ThunderFly-aerospace/MINI4/README.md

# TFESC
VESC-based ESC designed for unmanned drones
