ThunderFly-aerospace/MINI4/doc/gen/img/pcb/TFESC01-bottom.png

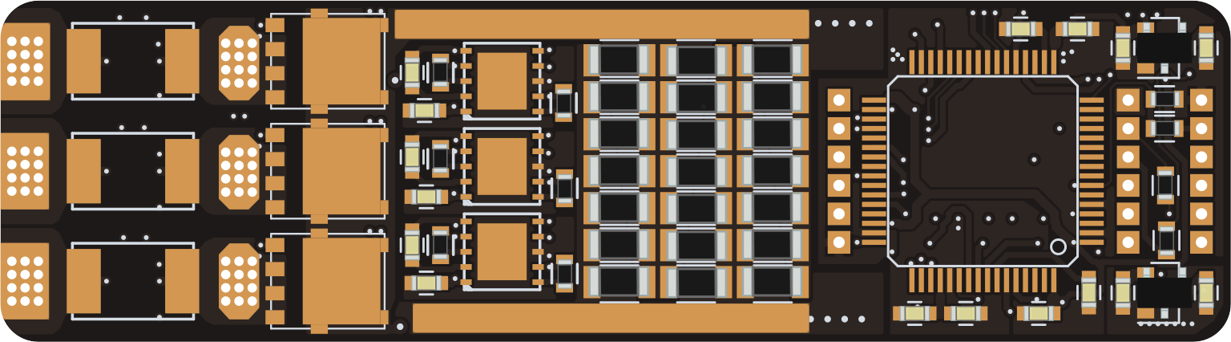
doc/gen/img/pcb/TFESC01-bottom.png
