ThunderFly-aerospace/MINI4/doc/gen/img/pcb/TFESC01-top.png

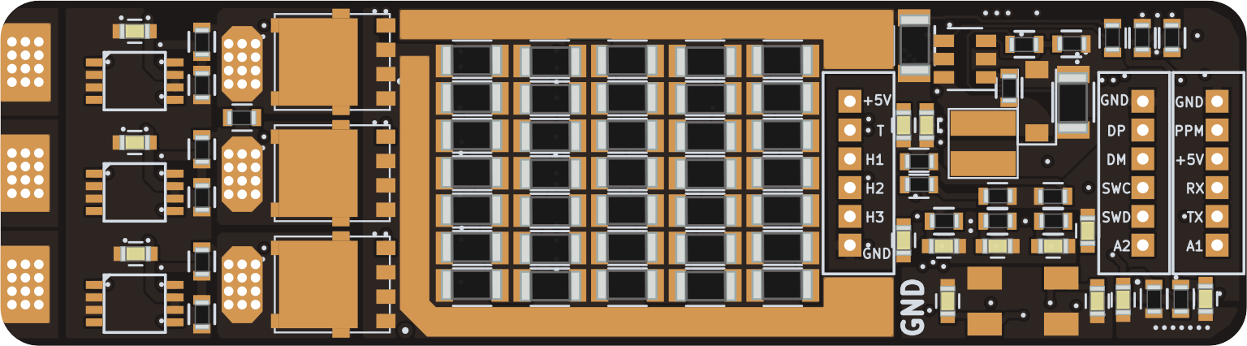
doc/gen/img/pcb/TFESC01-top.png
