ThunderFly-aerospace/MINI4/doc/gen/dxf/TFESC01-Edge_Cuts.dxf

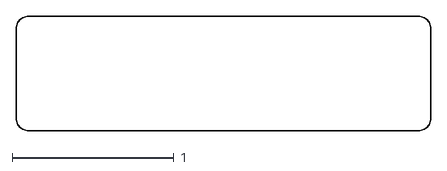
[picture p3: CAD file, 2022-12-15]
doc/gen/dxf/TFESC01-Edge_Cuts.dxf
2.56 x 0.709
