ThunderFly-aerospace/MINI4/doc/gen/TFESC01.step

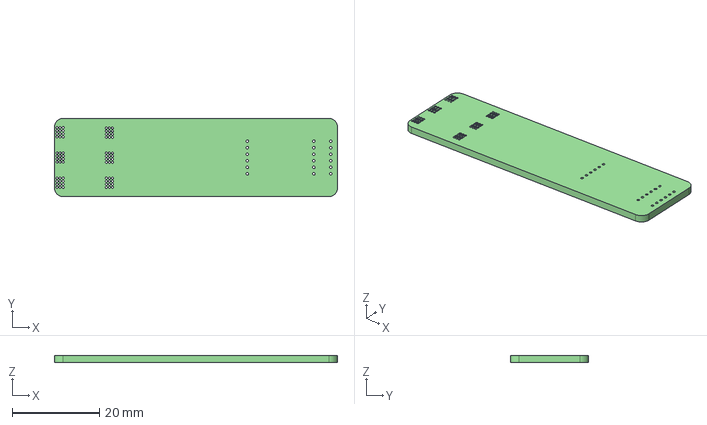
[picture p4: CAD file, 2022-12-15]
doc/gen/TFESC01.step
65.0 x 18.0 x 1.60 mm
