ThunderFly-aerospace/MINI4/doc/gen/dxf/TFESC01-B_Cu.dxf

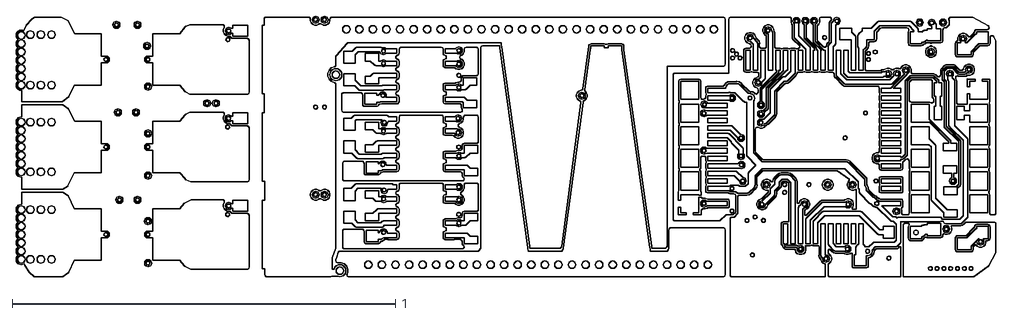
[picture p5: CAD file, 2022-12-15]
doc/gen/dxf/TFESC01-B_Cu.dxf
2.56 x 0.68
