ThunderFly-aerospace/MINI4/doc/gen/dxf/TFESC01-User_Drawings.dxf

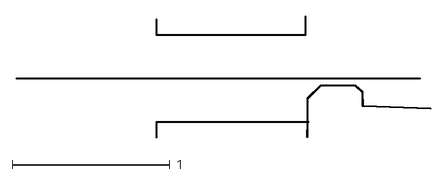
[picture p6: CAD file, 2022-12-15]
doc/gen/dxf/TFESC01-User_Drawings.dxf
2.63 x 0.772
