ThunderFly-aerospace/MINI4/hw/sch_pcb/3dmodels/3921_RESISTOR.STEP

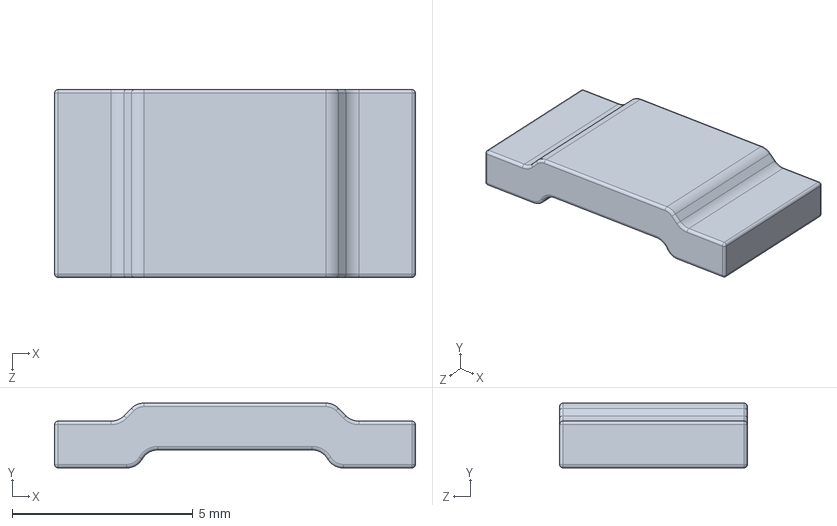
[picture p7: CAD file, 2022-12-15]
hw/sch_pcb/3dmodels/3921_RESISTOR.STEP
10.0 x 1.80 x 5.20 mm
