ThunderFly-aerospace/MINI4/doc/gen/dxf/TFESC01-F_Courtyard.dxf

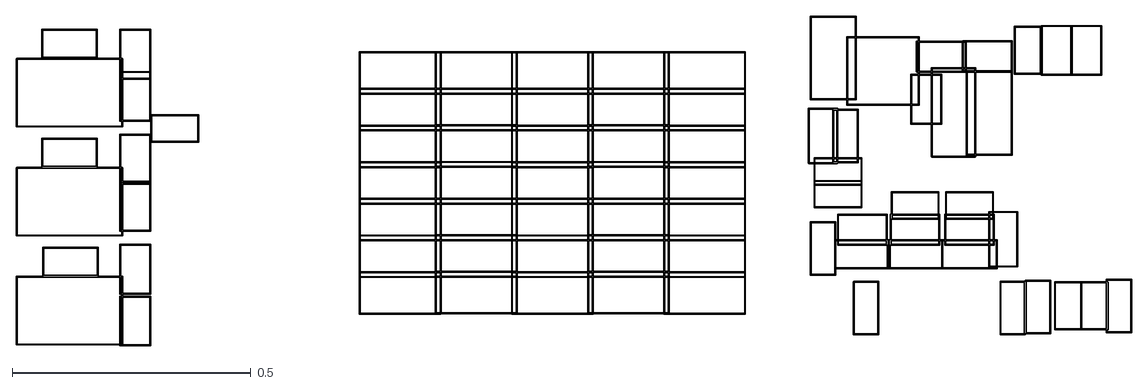
[picture p8: CAD file, 2022-12-15]
doc/gen/dxf/TFESC01-F_Courtyard.dxf
2.34 x 0.691
