ThunderFly-aerospace/MINI4/doc/gen/dxf/TFESC01-B_Courtyard.dxf

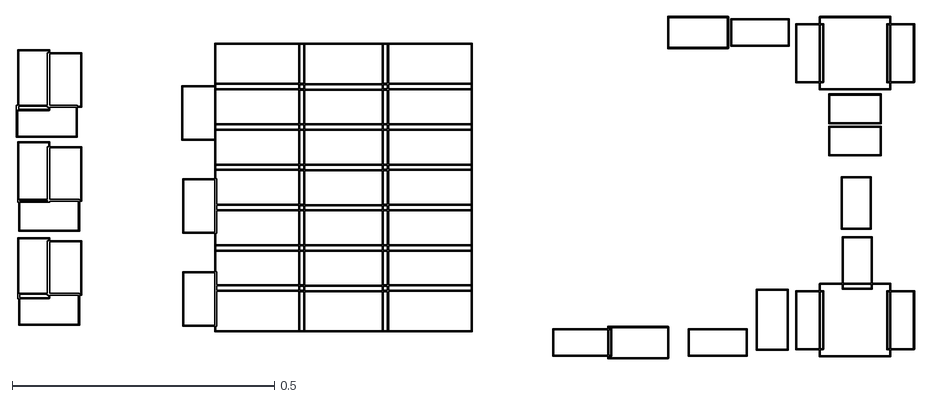
[picture p9: CAD file, 2022-12-15]
doc/gen/dxf/TFESC01-B_Courtyard.dxf
1.71 x 0.652
