ThunderFly-aerospace/MINI4/doc/gen/dxf/TFESC01-B_Fab.dxf

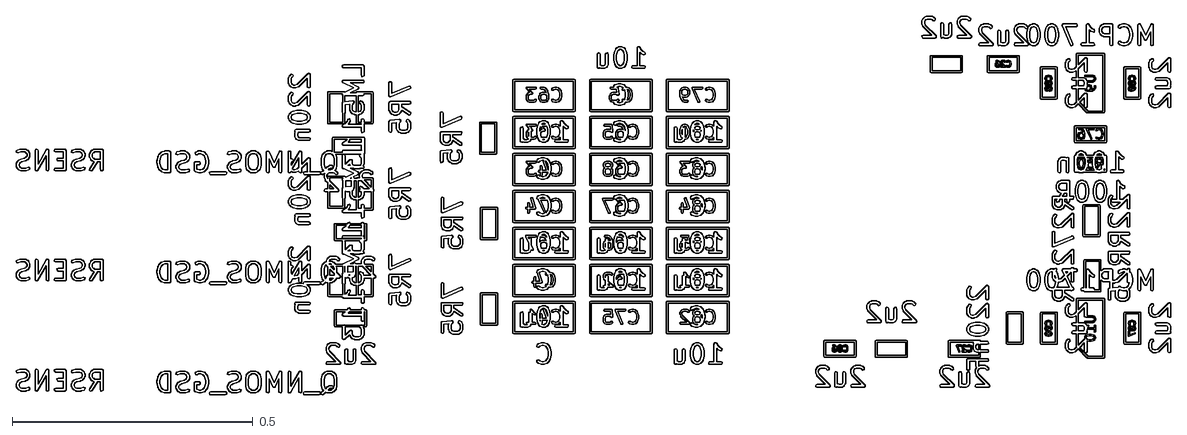
[picture p10: CAD file, 2022-12-15]
doc/gen/dxf/TFESC01-B_Fab.dxf
2.40 x 0.785
