ThunderFly-aerospace/MINI4/doc/gen/dxf/TFESC01-In2_Cu.dxf

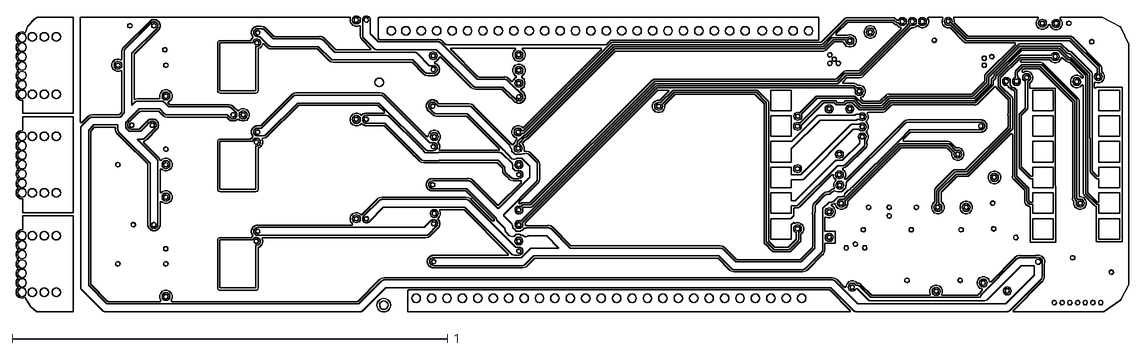
[picture p12: CAD file, 2022-12-15]
doc/gen/dxf/TFESC01-In2_Cu.dxf
2.56 x 0.68
