ThunderFly-aerospace/MINI4/doc/gen/dxf/TFESC01-F_Fab.dxf

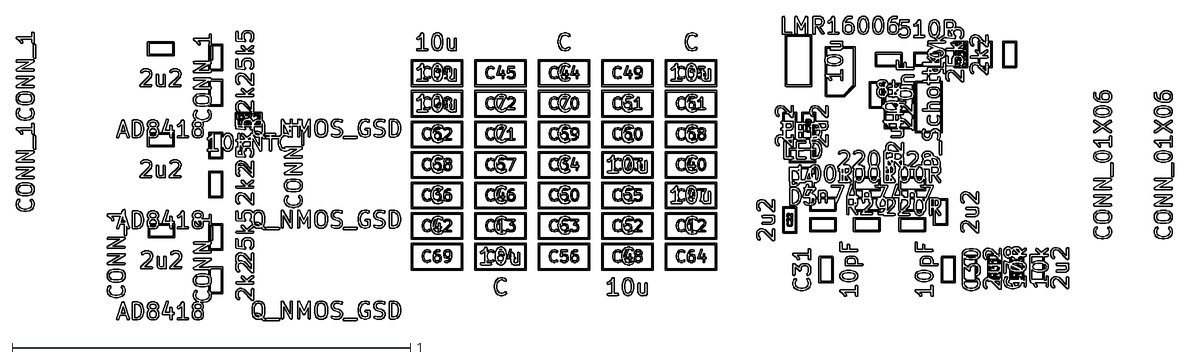
[picture p13: CAD file, 2022-12-15]
doc/gen/dxf/TFESC01-F_Fab.dxf
2.91 x 0.764
