ThunderFly-aerospace/MINI4/doc/gen/dxf/TFESC01-In1_Cu.dxf

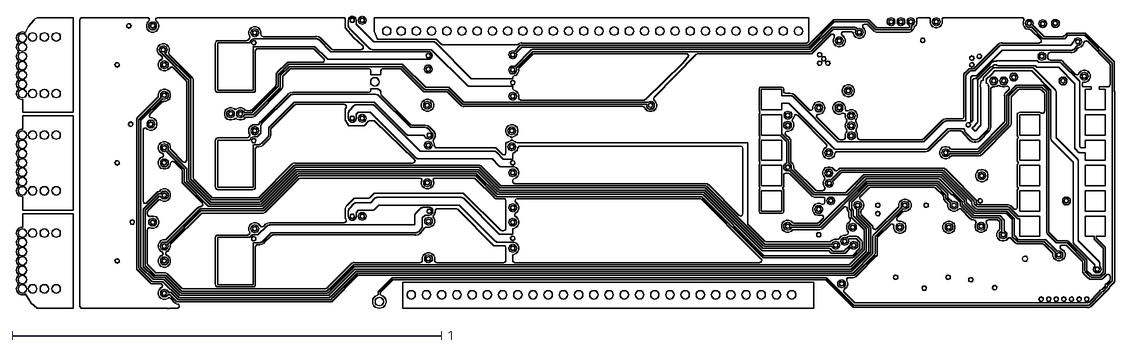
[picture p14: CAD file, 2022-12-15]
doc/gen/dxf/TFESC01-In1_Cu.dxf
2.56 x 0.68
