ThunderFly-aerospace/MINI4/(list of files, cad)

Other CAD files:
hw/sch_pcb/3dmodels/pqfn 5x6.wrl.sldprt
hw/sch_pcb/3dmodels/user library-pqfn 5x6.wrl.sldprt
doc/gen/dxf/TFESC01-User_Eco2.dxf
doc/gen/dxf/TFESC01-B_Adhesive.dxf
doc/gen/dxf/TFESC01-Margin.dxf
doc/gen/dxf/TFESC01-User_Eco1.dxf
doc/gen/dxf/TFESC01-User_Comments.dxf
doc/gen/dxf/TFESC01-F_Adhesive.dxf
doc/gen/dxf/TFESC01-B_Mask.dxf
doc/gen/dxf/TFESC01-B_Paste.dxf
doc/gen/dxf/TFESC01-B_Silkscreen.dxf
doc/gen/dxf/TFESC01-F_Mask.dxf
doc/gen/dxf/TFESC01-F_Paste.dxf
doc/gen/dxf/TFESC01-F_Silkscreen.dxf
