ThunderFly-aerospace/MINI4/doc/gen/TFESC01-schematic.pdf

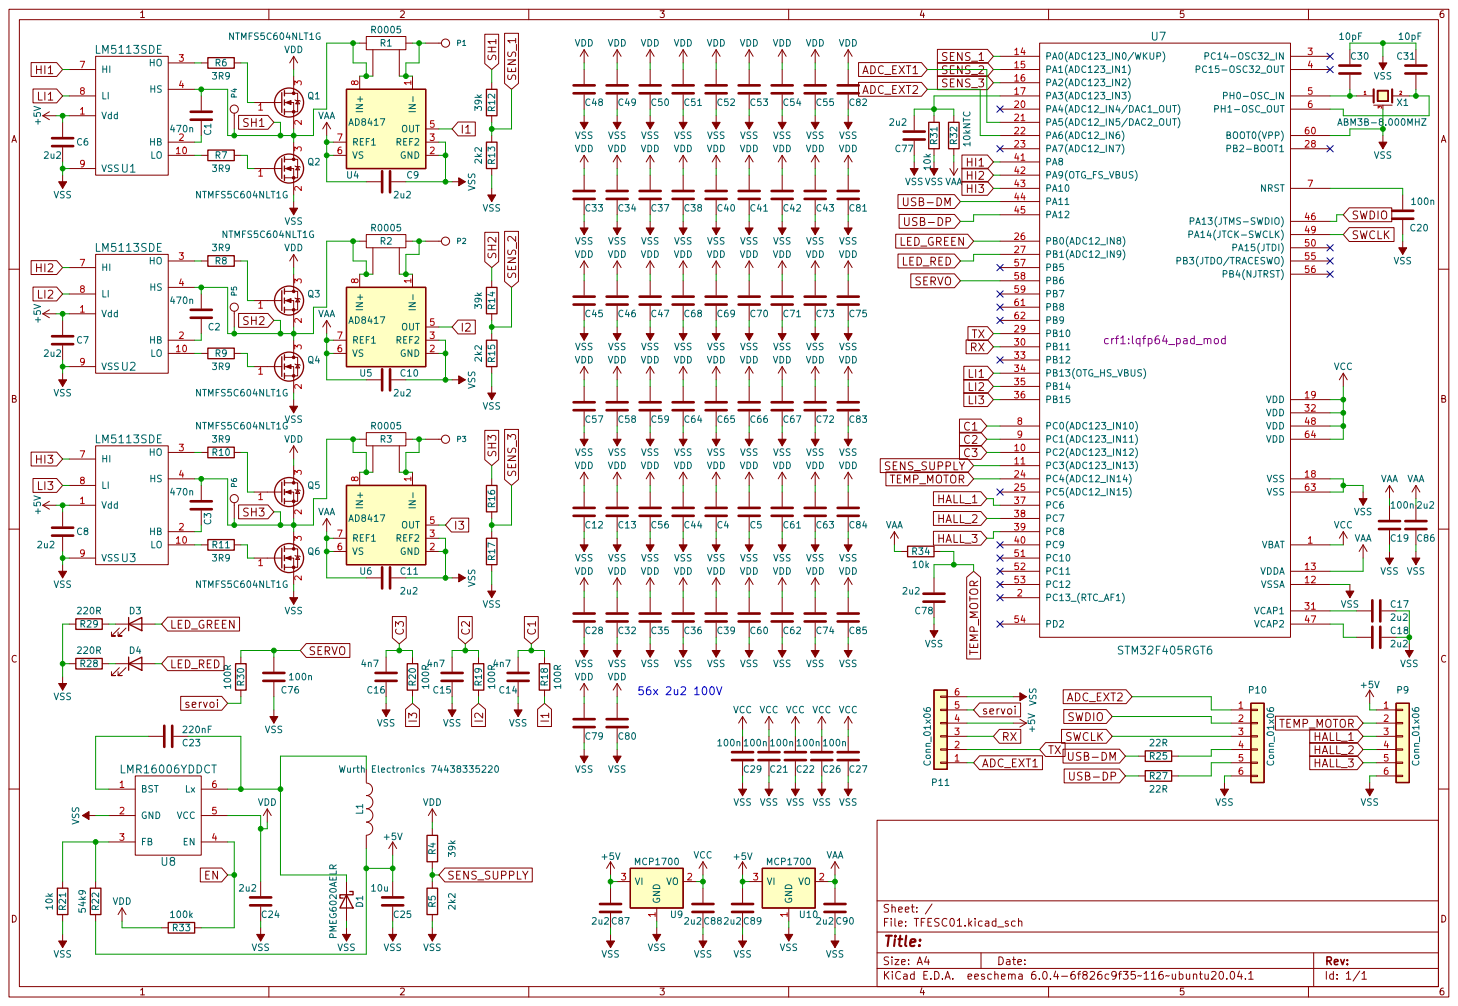
[picture p15: page 1]

2 3 Q5 NTMFS5C604NLT1G IN- 1 GND 2 REF2 3 OUT 5 VS 6 REF1 7 IN+

100n VCC VCC VCC VCC VCC
