ThunderFly-aerospace/MINI4/hw/sch_pcb/TFESC01.kicad_pcb

## KiCad design hw/sch_pcb/TFESC01.kicad_pcb (2022-12-15)

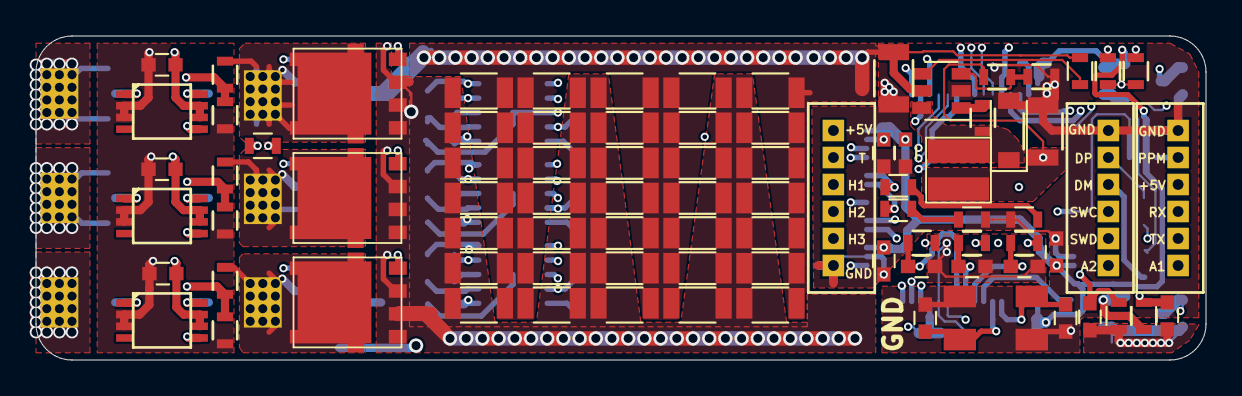
[picture p16: board TFESC01.kicad_pcb from above]

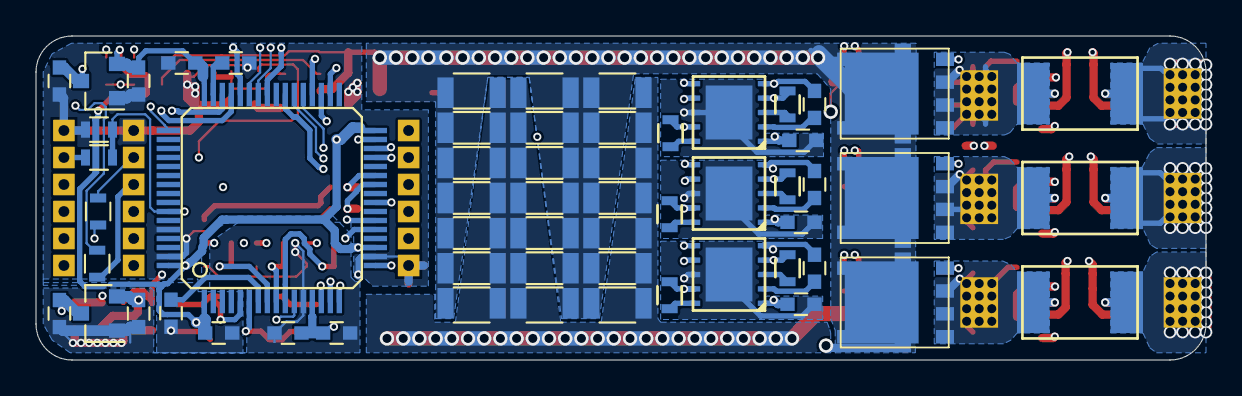
[picture p17: board TFESC01.kicad_pcb from below]

Board: 4 copper layers, 65.0 x 18.0 mm, 151 parts (59 on the bottom side), 72 nets.

Parts:
C1, C2, C3: 220n; C_0603
C4, C5, C12, C13, C24, C25, C28, C32, C39, C48, C60, C61, C62, C63, C74, C75, C79, C82, C84, C85: 10u; R_1206
C6, C7, C8, C9, C10, C11, C17, C18, C19, C21, C22, C26, C27, C29, C77, C78, C86, C87, C88, C89, C90: 2u2; C_0603
C14, C15, C16: 4n7; C_0603
C20: 220nF; C_0603
C23: 220nF; R_0603
C30, C31: 10pF; C_0603
C33, C34, C35, C36, C37, C38, C40, C41, C42, C43, C44, C45, C46, C47, C49, C50, C51, C52, C53, C54, C55, C56, C57, C58, C59, C64, C65, C66, C67, C68, C69, C70, C71, C72, C73, C80, C81, C83: C; R_1206
C76: 100n; R_0603
D1: D_Schottky; D_SOD-123
D3, D4: LED; R_0603
L1: 22uH; WE-MAPI
P1, P2, P3, P4, P5, P6: CONN_1; prekov
P9, P10, P11: CONN_01X06; JST_ZH_1.5_6-Pin
Q1, Q2, Q3, Q4, Q5, Q6: Q_NMOS_GSD; DFN5
R1, R2, R3: RSENS; 2512Rv2
R4, R12, R14, R16: 25k5; R_0603
R5, R13, R15, R17: 2k2; R_0603
R6, R7, R8, R9, R10, R11: 7R5; R_0603
R18, R19, R20, R30: 100R; R_0603
R21: 510R; R_0603
R22: 8k; R_0603
R25, R27: 22R; R_0603
R28, R29: 220R; R_0603
R31, R33, R34: 10k; R_0603
R32: 10kNTC; R_0603
U1, U2, U3: LM5113; WSON10_
U4, U5, U6: AD8418; MSOP
U7: STM32F40X_LQFP64; lqfp64_pad_mod
U8: LMR16006; SOT-23-6
U9, U10: MCP1700; SOT-23
X1: CRYSTAL_SMD; 5x3.2KRISTALL

Connections:
+5V: C6.1, C7.1, C8.1, C25.2, C87.1, C89.1, L1.2, P9.1, P11.4, R22.1, U1.1, U2.1, U3.1, U9.3, U10.3
ADC_EXT1: P11.1, U7.21
ADC_EXT2: P10.1, U7.22
C1: C14.2, R18.2, U7.8
C2: C15.2, R19.2, U7.9
C3: C16.2, R20.2, U7.10
EN: R33.2, U8.4
HALL_1: P9.3, U7.37
HALL_2: P9.4, U7.38
HALL_3: P9.5, U7.39
HI1: U1.6, U7.41
HI2: U2.6, U7.42
HI3: U3.6, U7.43
I1: R18.1, U4.5
I2: R19.1, U5.5
I3: R20.1, U6.5
LED_GREEN: D3.2, U7.26
LED_RED: D4.2, U7.27
LI1: U1.7, U7.34
LI2: U2.7, U7.35
LI3: U3.7, U7.36
unnamed: C1.1, U1.2
unnamed: C2.1, U2.2
unnamed: C3.1, U3.2
unnamed: C17.2, U7.31
unnamed: C18.2, U7.47
unnamed: C20.2, U7.7
unnamed: C23.1, D1.1, L1.1, U8.6
unnamed: C23.2, U8.1
unnamed: C30.1, U7.5, X1.1
unnamed: C31.1, U7.6, X1.2
unnamed: C77.2, R31.2, R32.2, U7.17
unnamed: D3.1, R29.2
unnamed: D4.1, R28.2
unnamed: P1.1, R1.1, U4.1
unnamed: P2.1, R2.1, U5.1
unnamed: P3.1, R3.1, U6.1
unnamed: P10.4, R25.1
unnamed: P10.5, R27.1
unnamed: Q1.1, R6.1, U1.4
unnamed: Q2.1, R7.2, U1.9
unnamed: Q3.1, R8.1, U2.4
unnamed: Q4.1, R9.2, U2.9
unnamed: Q5.1, R10.1, U3.4
unnamed: Q6.1, R11.2, U3.9
unnamed: R6.2, U1.3
unnamed: R7.1, U1.10
unnamed: R8.2, U2.3
unnamed: R9.1, U2.10
unnamed: R10.2, U3.3
unnamed: R11.1, U3.10
unnamed: R21.2, R22.2, U8.3
RX: P11.3, U7.30
SENS_1: R12.1, R13.2, U7.14
SENS_2: R14.1, R15.2, U7.15
SENS_3: R16.1, R17.2, U7.16
SENS_SUPPLY: R4.2, R5.2, U7.11
SERVO: C76.2, R30.2, U7.58
SH1: C1.2, P4.1, Q1.2, Q2.3, R1.2, R12.2, U1.5, U4.8
SH2: C2.2, P5.1, Q3.2, Q4.3, R2.2, R14.2, U2.5, U5.8
SH3: C3.2, P6.1, Q5.2, Q6.3, R3.2, R16.2, U3.5, U6.8
SWCLK: P10.3, U7.49
SWDIO: P10.2, U7.46
TEMP_MOTOR: C78.2, P9.2, R34.2, U7.24
TX: P11.2, U7.29
USB-DM: R25.2, U7.44
USB-DP: R27.2, U7.45
VAA: C9.2, C10.2, C11.2, C19.1, C86.1, C90.1, R32.1, R34.1, U4.6, U4.7, U5.6, U5.7, U6.6, U6.7, U7.13, U10.2
VCC: C21.1, C22.1, C26.1, C27.1, C29.1, C88.1, U7.1, U7.19, U7.32, U7.48, U7.64, U9.2
VDD: C4.1, C5.1, C12.1, C13.1, C24.2, C28.1, C32.1, C33.1, C34.1, C35.1, C36.1, C37.1, C38.1, C39.1, C40.1, C41.1, C42.1, C43.1, C44.1, C45.1, C46.1, C47.1, C48.1, C49.1, C50.1, C51.1, C52.1, C53.1, C54.1, C55.1, C56.1, C57.1, C58.1, C59.1, C60.1, C61.1, C62.1, C63.1, C64.1, C65.1, C66.1, C67.1, C68.1, C69.1, C70.1, C71.1, C72.1, C73.1, C74.1, C75.1, C79.1, C80.1, C81.1, C82.1, C83.1, C84.1, C85.1, Q1.3, Q3.3, Q5.3, R4.1, R33.1, U8.5
VSS: C4.2, C5.2, C6.2, C7.2, C8.2, C9.1, C10.1, C11.1, C12.2, C13.2, C14.1, C15.1, C16.1, C17.1, C18.1, C19.2, C20.1, C21.2, C22.2, C24.1, C25.1, C26.2, C27.2, C28.2, C29.2, C30.2, C31.2, C32.2, C33.2, C34.2, C35.2, C36.2, C37.2, C38.2, C39.2, C40.2, C41.2, C42.2, C43.2, C44.2, C45.2, C46.2, C47.2, C48.2, C49.2, C50.2, C51.2, C52.2, C53.2, C54.2, C55.2, C56.2, C57.2, C58.2, C59.2, C60.2, C61.2, C62.2, C63.2, C64.2, C65.2, C66.2, C67.2, C68.2, C69.2, C70.2, C71.2, C72.2, C73.2, C74.2, C75.2, C76.1, C77.1, C78.1, C79.2, C80.2, C81.2, C82.2, C83.2, C84.2, C85.2, C86.2, C87.2, C88.2, C89.2, C90.2, D1.2, P9.6, P10.6, P11.6, Q2.2, Q4.2, Q6.2, R5.1, R13.1, R15.1, R17.1, R21.1, R28.1, R29.1, R31.1, U1.8, U2.8, U3.8, U4.2, U4.3, U5.2, U5.3, U6.2, U6.3, U7.12, U7.18, U7.60, U7.63, U8.2, U9.1, U10.1, X1.3
servoi: P11.5, R30.1
