ThunderFly-aerospace/MINI4/(threads)

Thread 3 (2021-08-02):

Konektory

kaklik, 2021-08-02:
Konektory zvolit tak, aby bylo možné regulátor přímo propojovat s autopilotem. Aktuální situace je taková:

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

kaklik, 2022-12-17:
Konektory, které je potřeba doplnit:

- [ ] CAN konektor  - asi pouze jeden s tím že ESC bude vždy na konci sběrnice
- [ ] Dronecode debug port - Kotleta20 jej má společný s RCPWM vstupem.
- [ ] Napájecí konektor XT60
- [ ] 3F XT60 konektor pro připojení motoru

kaklik, 2023-01-08:
Vypadá to, že AMASS nevyrábí 3pin verzi konektoru XT60 do PCB, ale tenhle 3pin konektor je dostupný pouze ve variantě MR30, která má jmenovitý zatěžovací proud pouze 15A.

roman-dvorak, 2023-05-14:
Napájecí konektor by měl být takový (i všechny ostatní), aby co nejvíce zachovával kompatibilitu. (Pokud není zaměnitelný jiným osazením). Tj, aby do toho šlo zapojit koupitelné akumulátory či dostupné powermoduly.

kaklik, 2024-04-16:
Nově se teď objevilo [tohle ESC](https://www.hargravetechnologies.com/products/microdrive-lpi), jeho konstrukce je zajímavá zejména tím, že výkonové konektory nahradily letovacími maticemi pro šrouby podobně, jako to máme  vyřešené v QFH anténách.

Thread 2 (2022-12-09):

Výchozí design

kaklik, 2022-12-09:
Prohledával jsem výchozí KiCAD projekty ze kterých by bylo možné vyjít.  Hledal jsem zejména tyto parametry:

- Použití aktuálních součástek
- Využití KiCAD návrhu
- Udržovaný projekt.

Konkrétní projekt, který by tato kritéria perfektně splňoval jsem nenašel. Hlavní potíž je ta, že všechny projekty založené na VESC mají poslední commity několik roků zpátky. Nedovedu to vysvětlit, protože pro UAV vhodný design podle mě stále chybí.

Našel jsem ale:

- [VESC MINI4](https://github.com/norn93/AgriESC) - tohle [prodává holybro](http://www.holybro.com/product/holybro-mini-foc-esc-based-on-vesc6/) prakticky tak jak to je v původním repozitáři, dokonce na něj i přímo odkazuje. Bylo by nutné minimálně vyměnit konektory. Je dobré že nepočítá příliš s použitím elekrolytického kondenzátoru na vstupu. Existují od něj dvě varianty:

Tahle:
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

A z něj odvozená tato:

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

U ní se opět vrátily zpátky elektrolytické kondenzátory, což podle mě není žádná výhra.

- [Cheap FOCer 2 (v0.9)](https://github.com/shamansystems/Cheap-FOCer-2) zřejmě klon VESC 6, který má hlavní cíl být levný. Použití designu by vyžadovalo větší zásahy.

kaklik, 2022-12-16:
Tak jsem nakonec forknul větev z pull-requestu https://github.com/antonchromjak/MINI4/pull/4 , protože ta byla převedena alespoň na kicad5

kaklik, 2022-12-17:
Výchozí design je zřejmě vybrán, tím je toto issue vyřešeno.

Closed 2022-12-17.

Thread 1 (2022-12-15):

Capacitors mount

kaklik, 2022-12-15:

kaklik, 2022-12-17:
S tímhle řešením vznikl problém v tom, že něco takového nejde nakreslit ve schéma.  Znamenalo by to udělat nové pouzdro pro schématickou značku kondenzátoru.
Footprint ale neumí být operativně proměnný podle toho jak to zrovna vyjde na PCB.  Vypadá to tak, že tímto způsobem vznikne projektově specifický footprint, který bude platit jen pro konkrétní PCB.

Thread 4 (2022-12-17):

Kontrola schéma

kaklik, 2022-12-17:
Je potřeba zkontrolovat aktuální schéma oproti [schématům nových VESC](https://www.vesc-project.com/node/311), aby se ověřilo že nám neutekli žádné novinky, které se hodí.

kaklik, 2022-12-17:
Přidal jsem tam CAN konektor, který v původním schéma chyběl.
Je ale potřeba rozhodnout, jak má regulátor zacházet s 5V napájením, které na UAVCAN je. Má jej napájet?  Nebo jej má naopak používat?

Thread 5 (2022-12-17):

Problematické součástky

kaklik, 2022-12-17:
1. [Driver FET LM5113](https://www.ti.com/product/LM5113) není doporučený pro nové návrhy. Podle TI je náhradou [LMG1205](https://www.ti.com/product/LMG1205), ale ten je pouze v BGA pouzdře.

kaklik, 2023-01-31:
Možná by bylo řešením použít nějaký integrovaný driver včetně FET. Např.

- [MP86952](https://eu.mouser.com/datasheet/2/277/MP86952GMJ-3070465.pdf)

kaklik, 2024-05-22:
Postupně se objevují GaN spínače, které by bylo mozné rovnou použít a získat tak zřejmě i vyšší účinnost.

- [LMG2100R044](https://www.ti.com/lit/ds/symlink/lmg2100r044.pdf)  4.4mΩ, 90V

Thread 6 (2023-01-08):

Board Layout

kaklik, 2023-01-08:
Z diskuse s Miho vyplynulo, že zlepšení layoutu, je jedna z hlavních možností (kromě výměny součástek za aktuální #5), jak zlepšit aktuální design.

Jako problematické body vidí konkrétně:

- Připojení snímacích vodičů k ADC (zde pravděpodobně chybí i malý kondenzátor pro filtraci měřeného napětí)
- Layout ovládacích vodičů k tranzitorům
- Layout blokovacích kondenzátorů, podle něj by měly být pro připojení kondenzátorů použity prokovy, nikoliv #1.
- GND v návrhu podélného plošného spoje asi nemá smysl dělat více než jednu přes celou vnitřní vrstvu PCB.

Mezi další zlepšení patří vložení EMI filtru na vstup a případně na výstup ESC. Výstupní EMI filtr je ale v průmyslové praxi často nahrazován stíněním, které ale v našem případě asi není aplikovatelné.
Zbavit se vstupního EMI filtru by šlo v případě, že by byly enormně krátké vstupní přívody od akumulátoru (nejspíš přímo konektor pro akumulátor rovnou na PCB)

[213511.PDF](https://github.com/ThunderFly-aerospace/TFESC01/files/10369478/213511.PDF)
