ThunderFly-aerospace/MINI4/(commit log)

2022-12-15 Repository cleanup.
    [MINI VESC-B.Cu.gbl, MINI VESC-B.Mask.gbs, MINI VESC-B.Paste.gbp, MINI VESC-B.SilkS.gbo, MINI VESC-Edge.Cuts.gm1, MINI VESC-F.Cu.gtl, MINI VESC-F.Mask.gts, MINI VESC-F.Paste.gtp]
2022-12-15 Renaming the project.
    [TFESC01.kicad_pcb, TFESC01.kicad_sch]
2022-12-15 Change repository structure.
    Enable automation.
    [3921_RESISTOR.STEP, TFESC01.kicad_pcb, TFESC01.kicad_sch, pqfn 5x6.wrl.sldprt, user library-pqfn 5x6.wrl.sldprt]
2022-12-15 Update actions products
    [TFESC01-B_Adhesive.dxf, TFESC01-B_Courtyard.dxf, TFESC01-B_Cu.dxf, TFESC01-B_Fab.dxf, TFESC01-B_Mask.dxf, TFESC01-B_Paste.dxf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]
2022-12-16 Split schematics to multiple pages.
    [MCU.kicad_sch, TFESC01.kicad_sch, power.kicad_sch, power_stage.kicad_sch]
2022-12-18 CAN interface connector added #3
    [MCU.kicad_sch, TFESC01.kicad_sch, interfaces.kicad_sch, power.kicad_sch, power_stage.kicad_sch]
